Eng3mr5aled/Robolympics-Project/Turbo_Car Functions_Explained_EN.pptx

## TURBO TEAM

Team Members

Amr Khaled Sedik Mohamed Abdelhay
Mohamed Nabil Peter George
Ahmed Abd Aziz Essam Mohamed

Notes: Intro: this deck walks through the Main ESP32 firmware that drives a 4WD robot from a web dashboard, with an autonomous mode that keeps it from driving off track edges, plus the camera link and the gripper.

## ESP32 4WD Robot

A complete code walkthrough
Control • Dashboard • Autonomous
Camera • Gripper

LOW-LATENCY / RELIABLE VERSION

Notes: Intro: this deck walks through the Main ESP32 firmware that drives a 4WD robot from a web dashboard, with an autonomous mode that keeps it from driving off track edges, plus the camera link and the gripper.

## System Map

FaProjectDiagram

Dashboard

Phone / Laptop

Main ESP32

Access Point

ESP32-CAM

AI-Thinker

Laptop

Edge Impulse

WebSocket :81 + HTTP :80

UART 115200

Wi-Fi /capture

Laptop → robot: GET /detection

The Main ESP32 directly drives:

4 motors (H-Bridge)

Gripper (servo)

4 ultrasonic sensors

Notes: The Main ESP32 is the Wi-Fi access point (192.168.4.1). The dashboard talks to it over WebSocket for real-time control. The camera talks to it over UART for commands and its IP, and sends images to the laptop over Wi-Fi. The laptop runs inference and reports the result back with a /detection request.

## Network & Connectivity

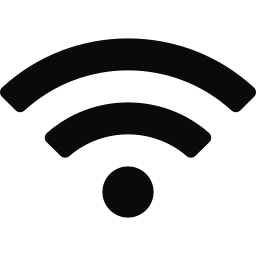
[picture p2: figure]
FaWifi

6

Wi-Fi channel

81

WebSocket port

80

HTTP port

4

Max clients

Fixed Access Point: SSID ESP32_Turbo at 192.168.4.1

FaNetworkWired

Lowest latency: Wi-Fi sleep off and max TX power

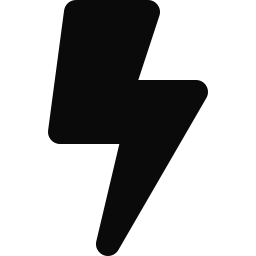
[picture p4: figure]
FaBolt

AP+STA mode with a locked channel (use 1, 6 or 11)

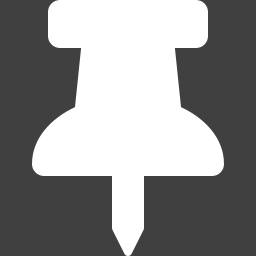
[picture p5: figure]
FaThumbtack

Notes: The robot creates an access point named ESP32_Turbo. The dashboard page is served on port 80 and the WebSocket runs on port 81. Low-latency settings: WiFi.setSleep(false), esp_wifi_set_ps(WIFI_PS_NONE) and esp_wifi_set_max_tx_power(78).

## Control

01

Motors • Steering • WebSocket commands

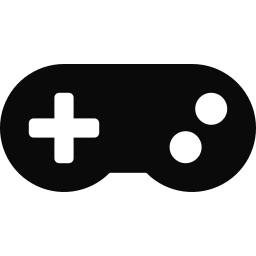
[picture p6: figure]
FaGamepad

Notes: Part one: how the robot moves and receives commands.

## Motor Control

Top view (F = forward pin, B = backward pin)

FaCogs

Each motor has two pins: forward and reverse (H-Bridge)

FaMicrochip

LF

22 / 23

RF

4 / 16

Speed via analogWrite PWM, from 0 to 255

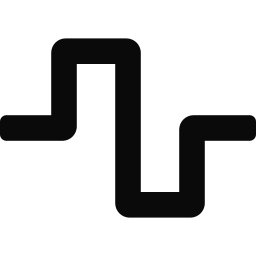
[picture p9: figure]
FaWaveSquare

Turn in place: one side forward, the other reverse (tank turn)

FaSyncAlt

LR

25 / 26

RR

17 / 18

Default speed is 255, changed with the SPD:n command

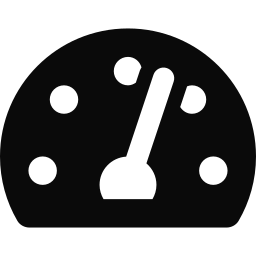
[picture p11: figure]
FaTachometerAlt

Notes: Each motor is wired to two pins on the H-Bridge (forward and reverse). setMotor() writes PWM to both. LF = 22/23, LR = 25/26, RF = 4/16, RR = 17/18.

## Steering & Failsafe

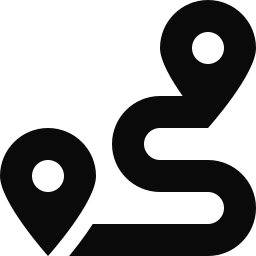
[picture p12: figure]
FaRoute

F

All wheels forward

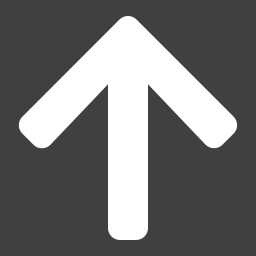
[picture p13: figure]
FaArrowUp

B

All wheels backward

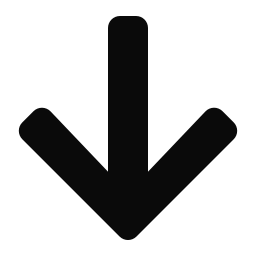
[picture p14: figure]
FaArrowDown

L

Left reverses, right goes forward

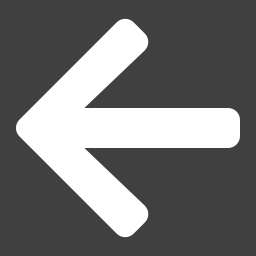
[picture p15: figure]
FaArrowLeft

R

Right reverses, left goes forward

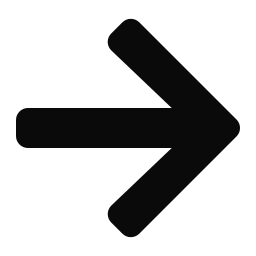
[picture p16: figure]
FaArrowRight

45%

Combined steering FL / FR / BL / BR: the inner side slows to 45% of speed instead of reversing (STEER_RATIO)

450ms

Failsafe: if no new command arrives within 450 ms, the robot stops by itself (CONTROL_TIMEOUT)

Notes: The combined commands FL/FR/BL/BR slow the inner side to 45% of speed. Any movement command has to keep arriving: if 450 ms pass with nothing new, stopAll() runs. This protects the robot if the connection drops.

## WebSocket Commands

F B L R S FL FR BL BR

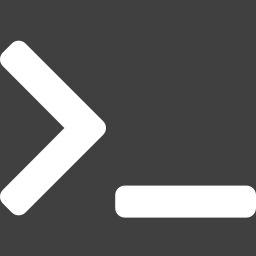
[picture p17: figure]
FaTerminal

Movement

SPD:200 (0 - 255)

Speed

AUTO:ON AUTO:OFF

Autonomous

CAM:ON CAM:OFF FLASH:ON FLASH:OFF

Camera

GRIP:OPEN GRIP:CLOSE

Gripper

HELLO → status PING:t → PONG:t

System

Notes: All commands are short text messages on the WebSocket (port 81). S is always allowed, even in AUTO mode, and it exits AUTO. Other movement commands are ignored while autonomous mode is running.

## Dashboard

02

An HTML page stored in PROGMEM and served by the ESP32

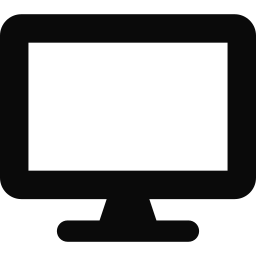
[picture p18: figure]
FaDesktop

Notes: Part two: the interface you drive the robot from.

## Dashboard Components

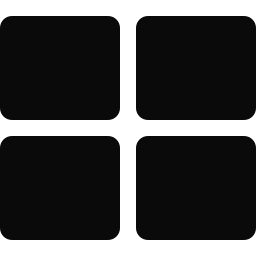
[picture p19: figure]
FaThLarge

Robot status

Current state plus WS, RTT and client count

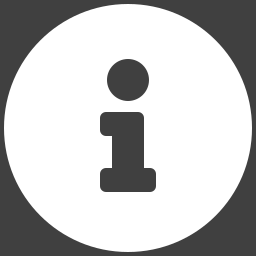
[picture p20: figure]
FaInfoCircle

Speed

Slider from 0 to 255 with + and − buttons

Arrow controls

Press and hold arrows, plus a red STOP button

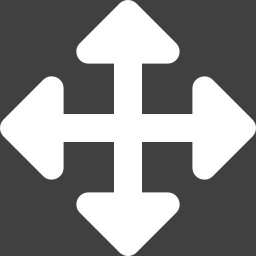
[picture p21: figure]
FaArrowsAlt

Control direction

Reverse button swaps forward and backward

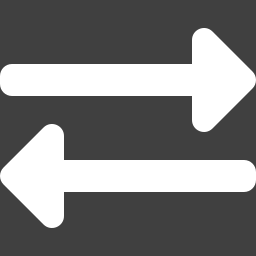
[picture p22: figure]
FaExchangeAlt

Autonomous

ON / OFF and the four sensor readings

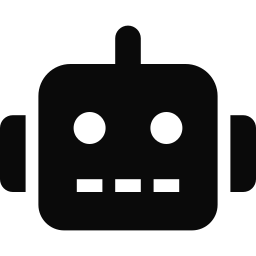
[picture p23: figure]
FaRobot

Camera + gripper

Camera, flash, detection result, grip open / close

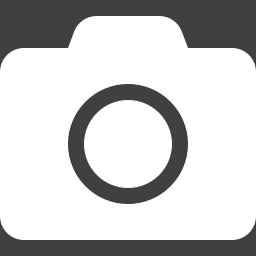
[picture p24: figure]
FaCamera

Notes: The dashboard is a single page embedded in the code (MAIN_page) and served at /. It has cards for status, speed, arrows, control reversal, autonomous mode, camera, the Edge Impulse result and the gripper.

## Keyboard Shortcuts

Emergency stop

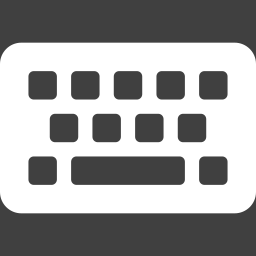
[picture p25: figure]
FaKeyboard

Move the robot

← ↑ ↓ →

SPACE

Gripper: open / close

G

R

Camera: on / off

C

D

Flash: on / off

Reverse controls

E

W

V

Autonomous: on / off

Speed: up / down

A

Q

+

−

Notes: Red keys stop things (SPACE and Q). Yellow keys are everything else. Arrow keys can be combined (for example up + left) for combined steering.

## Dashboard ⇄ Robot

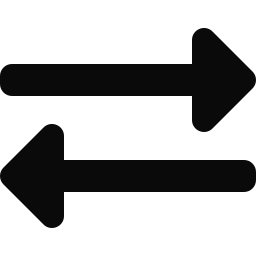
[picture p26: figure]
FaExchangeAlt

Auto-connect

WebSocket on port 81, retry every 300 ms

Status JSON example

1

Commands

Sent on change, plus a keepalive every 100 ms

2

Live status

Status JSON every 50 ms, RTT every second

3

Page safety

Losing focus or hiding the tab sends S

4

{"robot":"AUTO FORWARD","auto":true,"autoState":"FORWARD",
"lf":24.1,"rf":24.3,"ls":18.7,"rs":18.9,"lfGap":false,...}

Notes: The dashboard sends a command when it changes and again every 100 ms while a button is held, because the robot stops if 450 ms pass without a command. The robot pushes a JSON status every 50 ms.

## Autonomous

03

Raised track, no walls: don’t fall off the edge

Notes: Part three: the self-driving mode.

## How Autonomous Works

The hazard is the edge, not a wall: no wall following

FaExclamationTriangle
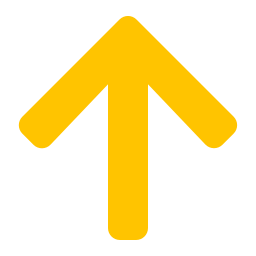
[picture p28: figure]
forward

4 HC-SR04 sensors aim at the ground: front LF/RF, side LS/RS

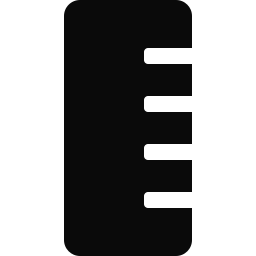
[picture p29: figure]
FaRulerVertical

LF

RF

ECHO must drop from 5 V to 3.3 V (2k / 3.9k divider)

LS

RS

On AUTO start, each sensor learns the normal ground distance

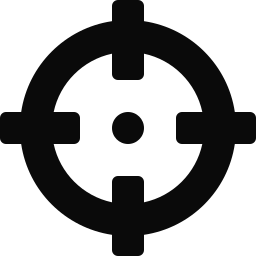
[picture p30: figure]
FaCrosshairs

edge

edge

LF 27/34 · RF 19/35 · LS 14/36 · RS 13/39

Notes: The track is raised and has no walls, so the edges are the hazard. The sensors point down at the ground. The numbers in the last box are TRIG/ECHO pins for each sensor. Dropping ECHO from 5 V to 3.3 V is essential.

## Filtering & Calibration

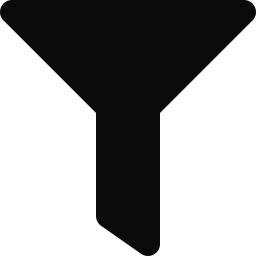
[picture p31: figure]
FaFilter

Calibrate

5 readings set the ground baseline

1

Median-of-5

Median of the last 5 readings removes spikes

2

Delta

Reading minus baseline; a rise means an edge

3

Hysteresis

Warning clears only 1.5 cm below the limit

4

5 / 10 cm

Front sensor: warn / danger

4 / 8 cm

Side sensor: warn / danger

× 2

Two no-echo reads = danger

Notes: Each sensor is calibrated against the normal ground distance (the first 5 valid readings under 150 cm, taken while stopped). Danger is decided by the difference from that baseline, not by a fixed distance. Two no-echo reads in a row count as an edge, because the ground has disappeared.

## Autonomous States

CALIBRATING

Calibrates while stopped

FORWARD

Drives at speed 170

BRAKING

Brake for 80 ms

TURN L / R

Turn 180-420 ms

Sensors ready

Front edge

After 80 ms

Turn done and path clear: back to FORWARD

HAZARD STOP

From any state: stale sensor • two edges at once • turn over 420 ms. Stays stopped until AUTO OFF.

Notes: After calibration the robot enters FORWARD. If a front edge appears it brakes for 80 ms, then turns away from the edge (edge on the left means turn right, and the other way round). After the turn it returns to FORWARD. Any dangerous situation goes to HAZARD STOP, a terminal state until you switch autonomous mode off and on again.

## Decision Priority

Stale sensor (over 220 ms) or not calibrated → HAZARD STOP

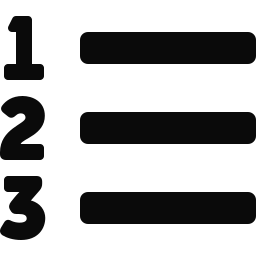
[picture p32: figure]
FaListOl

1

Both front edges (after 80 ms) or both side edges → HAZARD STOP

2

While turning: if an edge shows on the turn side, reverse the turn

3

Front edge on LF or RF → brake 80 ms, then turn away from it

4

Side edge → steer away from it (inner side at 35% speed)

5

Side warning → gradual steering; both sides → speed 120, otherwise 170

6

Notes: This is the order of checks in autonomousService(): safety first, then the front edge, then side edges, and gradual steering last. Number 1 has the highest priority.

## Safety Layers in Numbers

FaShieldAlt

220ms

Max sensor reading age before stopping

450ms

Control command timeout before stopping

80ms

Confirmation time for a double front edge

420ms

Max duration of a single turn

4s

Camera link timeout (NO LINK)

35%

Autonomous steering ratio (0.35)

Notes: Safety comes in layers: sensor reading expiry, command timeout, confirmation time, a turn time limit and the camera timeout. Manual steering is unchanged; autonomous mode uses its own 0.35 ratio.

## Camera & Gripper

04

UART • Edge Impulse • Servo

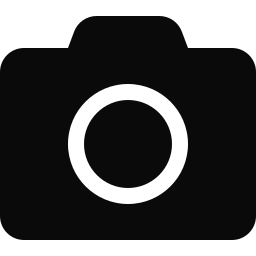
[picture p34: figure]
FaCamera

Notes: Part four: the camera and the gripper.

## Camera UART Link

Protocol

Main → Cam : CAM_ON | CAM_OFF
FLASH_ON | FLASH_OFF
Cam → Main : CAM_STATE:ON/OFF
CAM_FLASH:ON/OFF
CAM_IP:192.168.4.X

Wiring

MAIN GPIO32 TX → CAM GPIO3 RX
MAIN GPIO33 RX ← CAM GPIO1 TX
MAIN GND → CAM GND
Baud 115200

400ms

Command retry interval

10

Max tries, then NO LINK

4s

Heartbeat timeout

Notes: Commands between the Main ESP32 and the camera travel over UART. The camera reports its DHCP IP so the laptop knows where to request /capture. The Main resends an ON/OFF command every 400 ms up to 10 times, and restores the desired state automatically if the camera reboots.

## Shape Detection (Edge Impulse)

FaEye

Camera

Serves images at /capture

Example request

Laptop

Edge Impulse runs inference

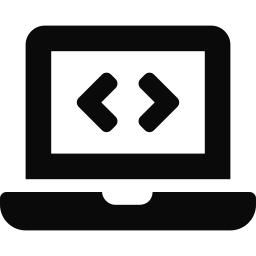
[picture p36: figure]
FaLaptopCode

Robot

Receives the result at /detection

Dashboard

Shows Pyramid / Cube / Ball

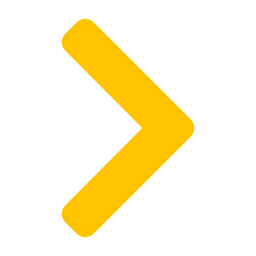
[picture p37: figure]
next

/detection?label=Pyramid&confidence=0.94&p=0.94&c=0.03&b=0.02

Scores are accepted as 0..1 or 0..100; the dashboard parses P / C / B from the text

Notes: Detection runs on the laptop, not on the robot. The Main only receives the result and stores it in detectionText. The dashboard reads the Pyramid / Cube / Ball scores with a regex from the P:xx C:xx B:xx text.

## Gripper (Servo)

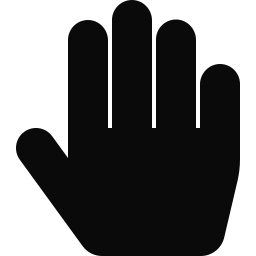
[picture p38: figure]
FaHandPaper

GPIO 21

Servo pin

50 Hz

PWM, 16 bits resolution

5°–180°

Open → close

500–2400

Pulse width in µs

Angle 0–180°

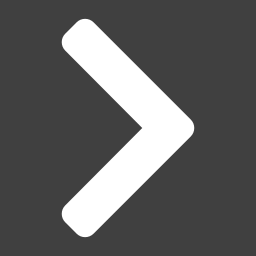
[picture p39: figure]
next

Pulse width µs

duty ÷ 20000µs

ledcWrite

Commands: GRIP:OPEN / GRIP:CLOSE, or the G and R keys. The state (OPEN / CLOSED) shows on the dashboard.

Notes: The gripper runs on LEDC at GPIO 21 with a 50 Hz, 16-bit signal. servoWriteAngle() converts the angle to a pulse width between 500 and 2400 microseconds, then to a duty value.

## Thank You

- Made by Amr Khaled Sedik , Computer Engineer
